guoyijiang/NUEDC_Oscilloscope/FPGA/.Xil/top_propImpl.xdc

set_property SRC_FILE_INFO {cfile:D:/Projects/VivadoProject/XC7A35TFTG256_1/p2017/SlaveTerminal_example/SlaveTerminal_example.srcs/constrs_1/new/ll7a35ek_master_HSADxDA.xdc rfile:../SlaveTerminal_example.srcs/constrs_1/new/ll7a35ek_master_HSADxDA.xdc id:1} [current_design]
set_property src_info {type:XDC file:1 line:38 export:INPUT save:INPUT read:READ} [current_design]
set_property PACKAGE_PIN P5  [get_ports led[0]];
set_property src_info {type:XDC file:1 line:39 export:INPUT save:INPUT read:READ} [current_design]
set_property PACKAGE_PIN L5  [get_ports led[1]];
set_property src_info {type:XDC file:1 line:40 export:INPUT save:INPUT read:READ} [current_design]
set_property PACKAGE_PIN N4  [get_ports led[2]];
set_property src_info {type:XDC file:1 line:41 export:INPUT save:INPUT read:READ} [current_design]
set_property PACKAGE_PIN P4  [get_ports led[3]];
set_property src_info {type:XDC file:1 line:42 export:INPUT save:INPUT read:READ} [current_design]
set_property PACKAGE_PIN M4  [get_ports led[4]];
set_property src_info {type:XDC file:1 line:43 export:INPUT save:INPUT read:READ} [current_design]
set_property PACKAGE_PIN L4  [get_ports led[5]];
set_property src_info {type:XDC file:1 line:44 export:INPUT save:INPUT read:READ} [current_design]
set_property PACKAGE_PIN P3  [get_ports led[6]];
set_property src_info {type:XDC file:1 line:45 export:INPUT save:INPUT read:READ} [current_design]
set_property PACKAGE_PIN N3  [get_ports led[7]];
set_property src_info {type:XDC file:1 line:46 export:INPUT save:INPUT read:READ} [current_design]
set_property IOSTANDARD LVCMOS33 [get_ports {led[*]}];
set_property src_info {type:XDC file:1 line:155 export:INPUT save:INPUT read:READ} [current_design]
set_property IOSTANDARD LVCMOS33 [get_ports -of_objects [get_iobanks 34]];
