guoyijiang/NUEDC_Oscilloscope/(notices)

Notices in the files:
MCU/HARDWARE/TIMER/timer.c:
Copyright(C) ¹ãÖÝÊÐÐÇÒíµç×Ó¿Æ¼¼ÓÐÏÞ¹«Ë¾ 2014-2024
All rights reserved
